buchtawill/wpi-grad-led/2025/invoice.pdf

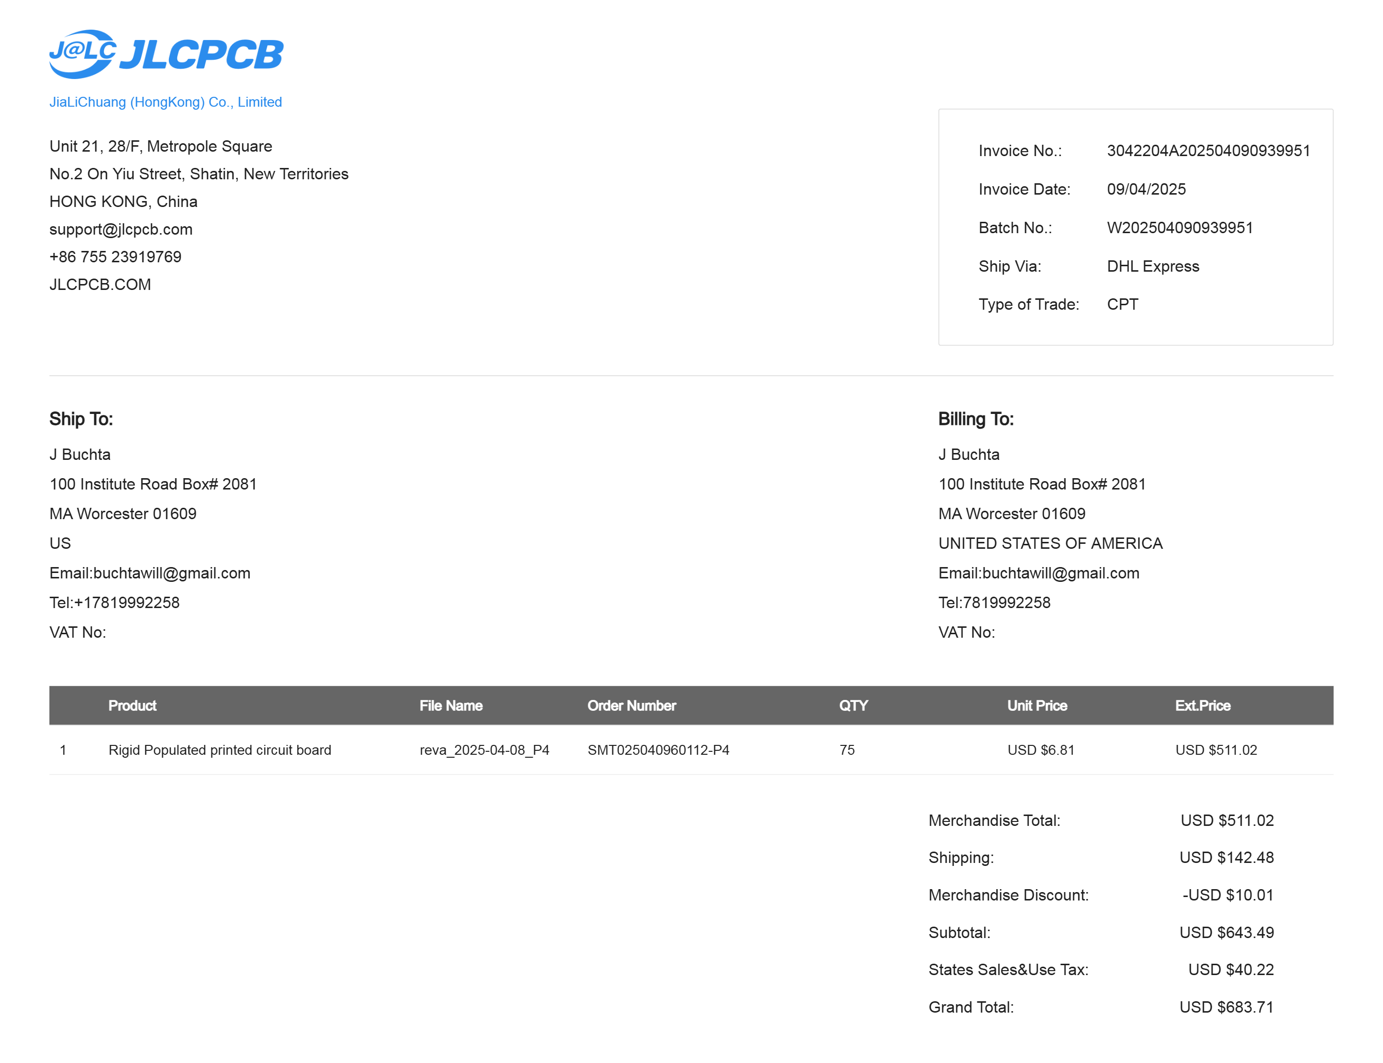
[picture p2: figure]
