buchtawill/wpi-grad-led/2025/cc_statement.png

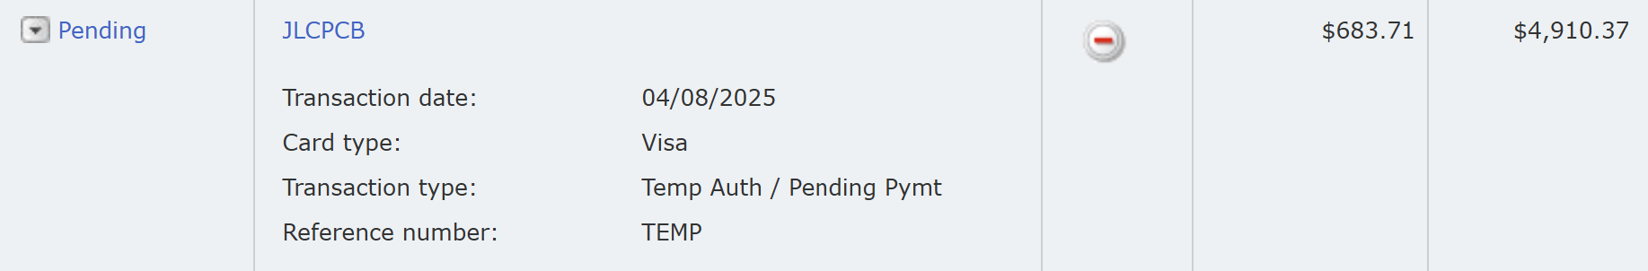
2025/cc_statement.png
