buchtawill/wpi-grad-led/2025/ece2025LEDs_animation.gif

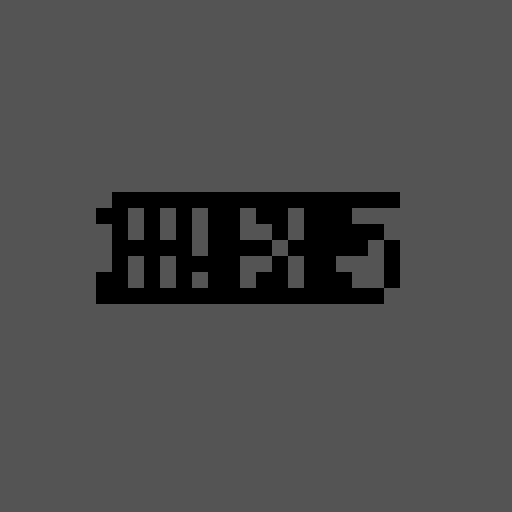
2025/ece2025LEDs_animation.gif
