buchtawill/wpi-grad-led/2025/ece2025LEDs_merged.png

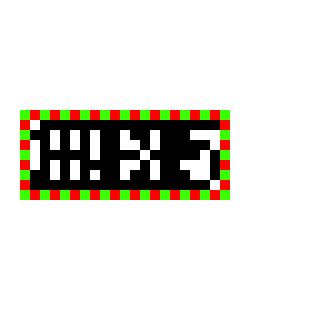
2025/ece2025LEDs_merged.png
