buchtawill/wpi-grad-led/2025/costs.xlsx

No charging CR2450
Item | Part # | Unit cost | Qty | Extended
CR2450 | 490-18648-ND | 0.5954 | 100 | 59.54
Boost | C2071163 | 0.1235 | 100 | 12.35
BJT | C2150 | 0.0119 | 900 | 10.71
LED | C22461786 | 0.0095 | 10000 | 95 | 101.65 if ordering 9500
DFF - xx174 | C6828 | 0.2166 | 100 | 21.66
NE555 | C7593 | 0.0806 | 100 | 8.06
USBC | C165948 | 0.1335 | 100 | 13.35
Resistors |  |  |  | 0
 |  |  |  | 0
 |  |  |  | 220.67
 |  |  | Assuming 50-60 boards
Second Revision | Unit Cost | Qty per board | Extended | Link / pn
Bulk AAs | 0.15 | 2 | 0.3 | https://a.co/d/etzIdbg
AA Holder | 0.38 | 1 | 0.38 | https://a.co/d/iyl8QFg
Shift Register | 0.0918 | 1 | 0.0918 | C5947
PCA9635 | 1.2645 | 3 | 3.7935 | C2678753
STM32F030 | 0.5415 | 1 | 0.5415 | C62514
 |  |  | 0
 |  |  | 0
 |  |  | 0
 |  |  | 0
 |  |  | 0
 |  | Total / board | 5.1068
