buchtawill/wpi-grad-led/2025/eagle/bom/bom_jlc.xlsx

Qty | Value | Device | Package | Parts | JLCPCB Part Number
9 |  | NPN-TRANSISTOR_SOT23 | SOT23 | Q1, Q2, Q3, Q4, Q5, Q6, QB, QG, QR | C2150
92 | 470 | R-US_R0603 | R0603 | R3, R4, R5, R6, R7, R8, R9, R10, R11, R12, R13, R14, R15, R16, R17, R18, R19, R20, R21, R22, R23, R24, R25, R26, R27, R28, R29, R30, R31, R32, R33, R34, R35, R36, R37, R38, R39, R40, R41, R42, R43, R44, R45, R46, R47, R48, R49, R50, R51, R52, R53, R54, R55, R56, R57, R58, R59, R60, R61, R62, R63, R64, R65, R66, R67, R68, R69, R70, R71, R72, R73, R74, R75, R77, R78, R79, R80, R81, R82, R83, R84, R85, R86, R87, R88, R89, R90, R91, R92, R93, R94, R95, R1, R2, R98, R99, R100 | C23179
1 | 100 | R-US_R0603 | R0603 | R108 | C23162
4 | 100n | C-USC0603 | C0603 | C1, C3, C5, C6 | C1591
5 | 10u | C-USC0805 | C0805 | C2, C4, C7, C8 | C1713
7 | 4k7 | R-US_R0603 | R0603 | R101, R102, R103, R104, R105, R106, R107 | C23162
1 | 74HC174D | 74HC174D | SO16 | IC2 | C6828
1 | 680k | R-US_R0603 | R0603 | R76 | C25822
4 | 75k | R-US_R0603 | R0603 | R96, R97, R109, R110 | C23242
1 | CR2450 | CR2450 | CR240_CASE | BAT1 | C964806
1 | LM555D | LM555D | SO08 | IC1 | C7593
1 | LQH3NPN2R2MJRL | LQH3NPN2R2MJRL | IND_LQH3NPN2R2MJRL | L1 | C9890
94 | RGB_LED_XL | RGB_LED_XL | LED2727 | DA2, DA3, DA4, DA5, DA6, DA7, DA8, DA9, DA10, DA11, DA12, DA13, DA14, DA15, DA16, DA17, DA18, DA19, DB1, DB2, DB4, DB6, DB8, DB9, DB11, DB12, DB14, DB15, DB16, DC2, DC4, DC6, DC8, DC9, DC12, DC14, DC15, DC16, DC17, DC18, DD2, DD3, DD4, DD5, DD6, DD8, DD9, DD10, DD11, DD13, DD14, DD15, DD16, DD17, DD19, DE2, DE4, DE6, DE7, DE8, DE9, DE12, DE14, DE15, DE19, DF1, DF2, DF4, DF6, DF8, DF9, DF11, DF12, DF14, DF15, DF19, DG1, DG2, DG3, DG4, DG5, DG6, DG7, DG8, DG9, DG10, DG11, DG12, DG13, DG14, DG15, DG16, DG17, DG18 | C22461786
1 | SWITCH-BRUH | SWITCH-BRUH | SW-K31391B | PWR | C92656
1 | TPS63000DRCR | TPS63000DRCR | VREG_V62/16624-01YE | U1 | C2876573
1 | TYPE-C-31-M-12 | TYPE-C-31-M-12 | HRO_TYPE-C-31-M-12 | J1 | C165948
