buchtawill/wpi-grad-led/2025/eagle/reva_sch.pdf

A
B

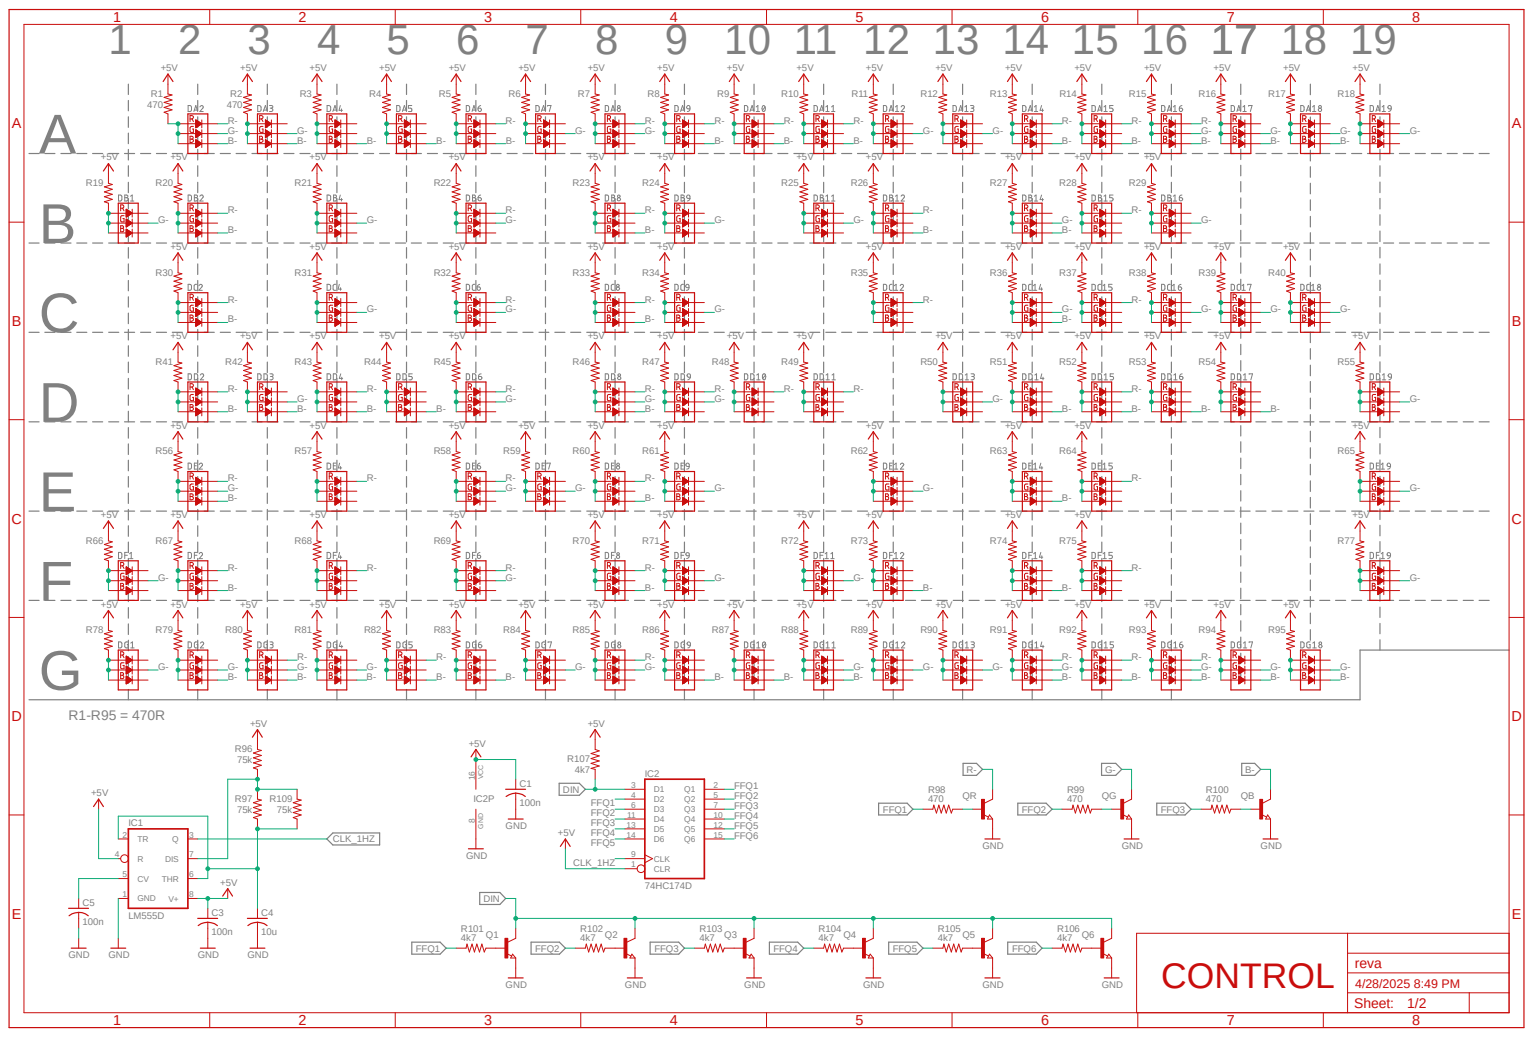
[picture p6: page 1]

CONTROL

Sheet: 1/2

A

A

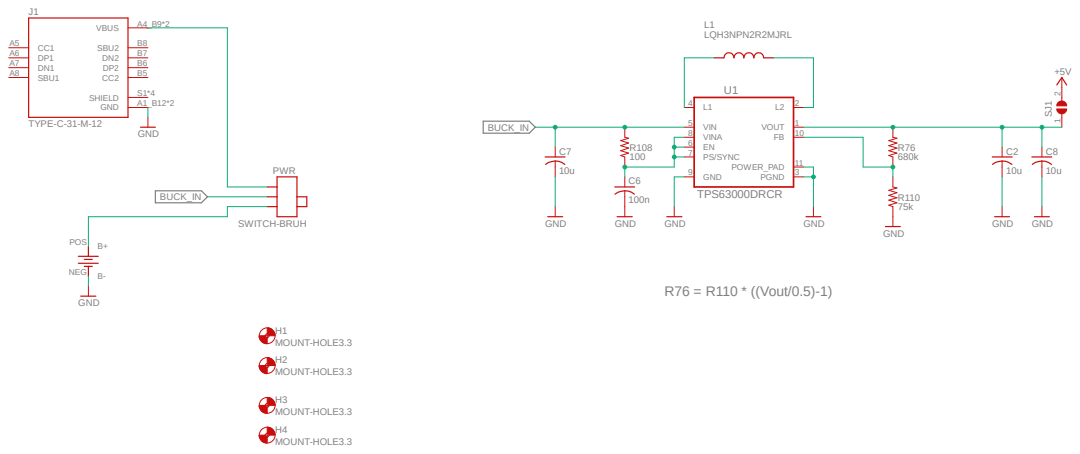
[picture p7: page 2]

+5V MOUNT-HOLE3.3 MOUNT-HOLE3.3 MOUNT-HOLE3.3 MOUNT-HOLE3.3

R76 = R110 * ((Vout/0.5)-1) SWITCH-BRUH GND
H1 H2 H3 H4 B+ POS

PWR

Sheet: 2/2
