buchtawill/wpi-grad-led/2025/eagle/reva.brd

## EAGLE design 2025/eagle/reva.brd (2026-03-22)

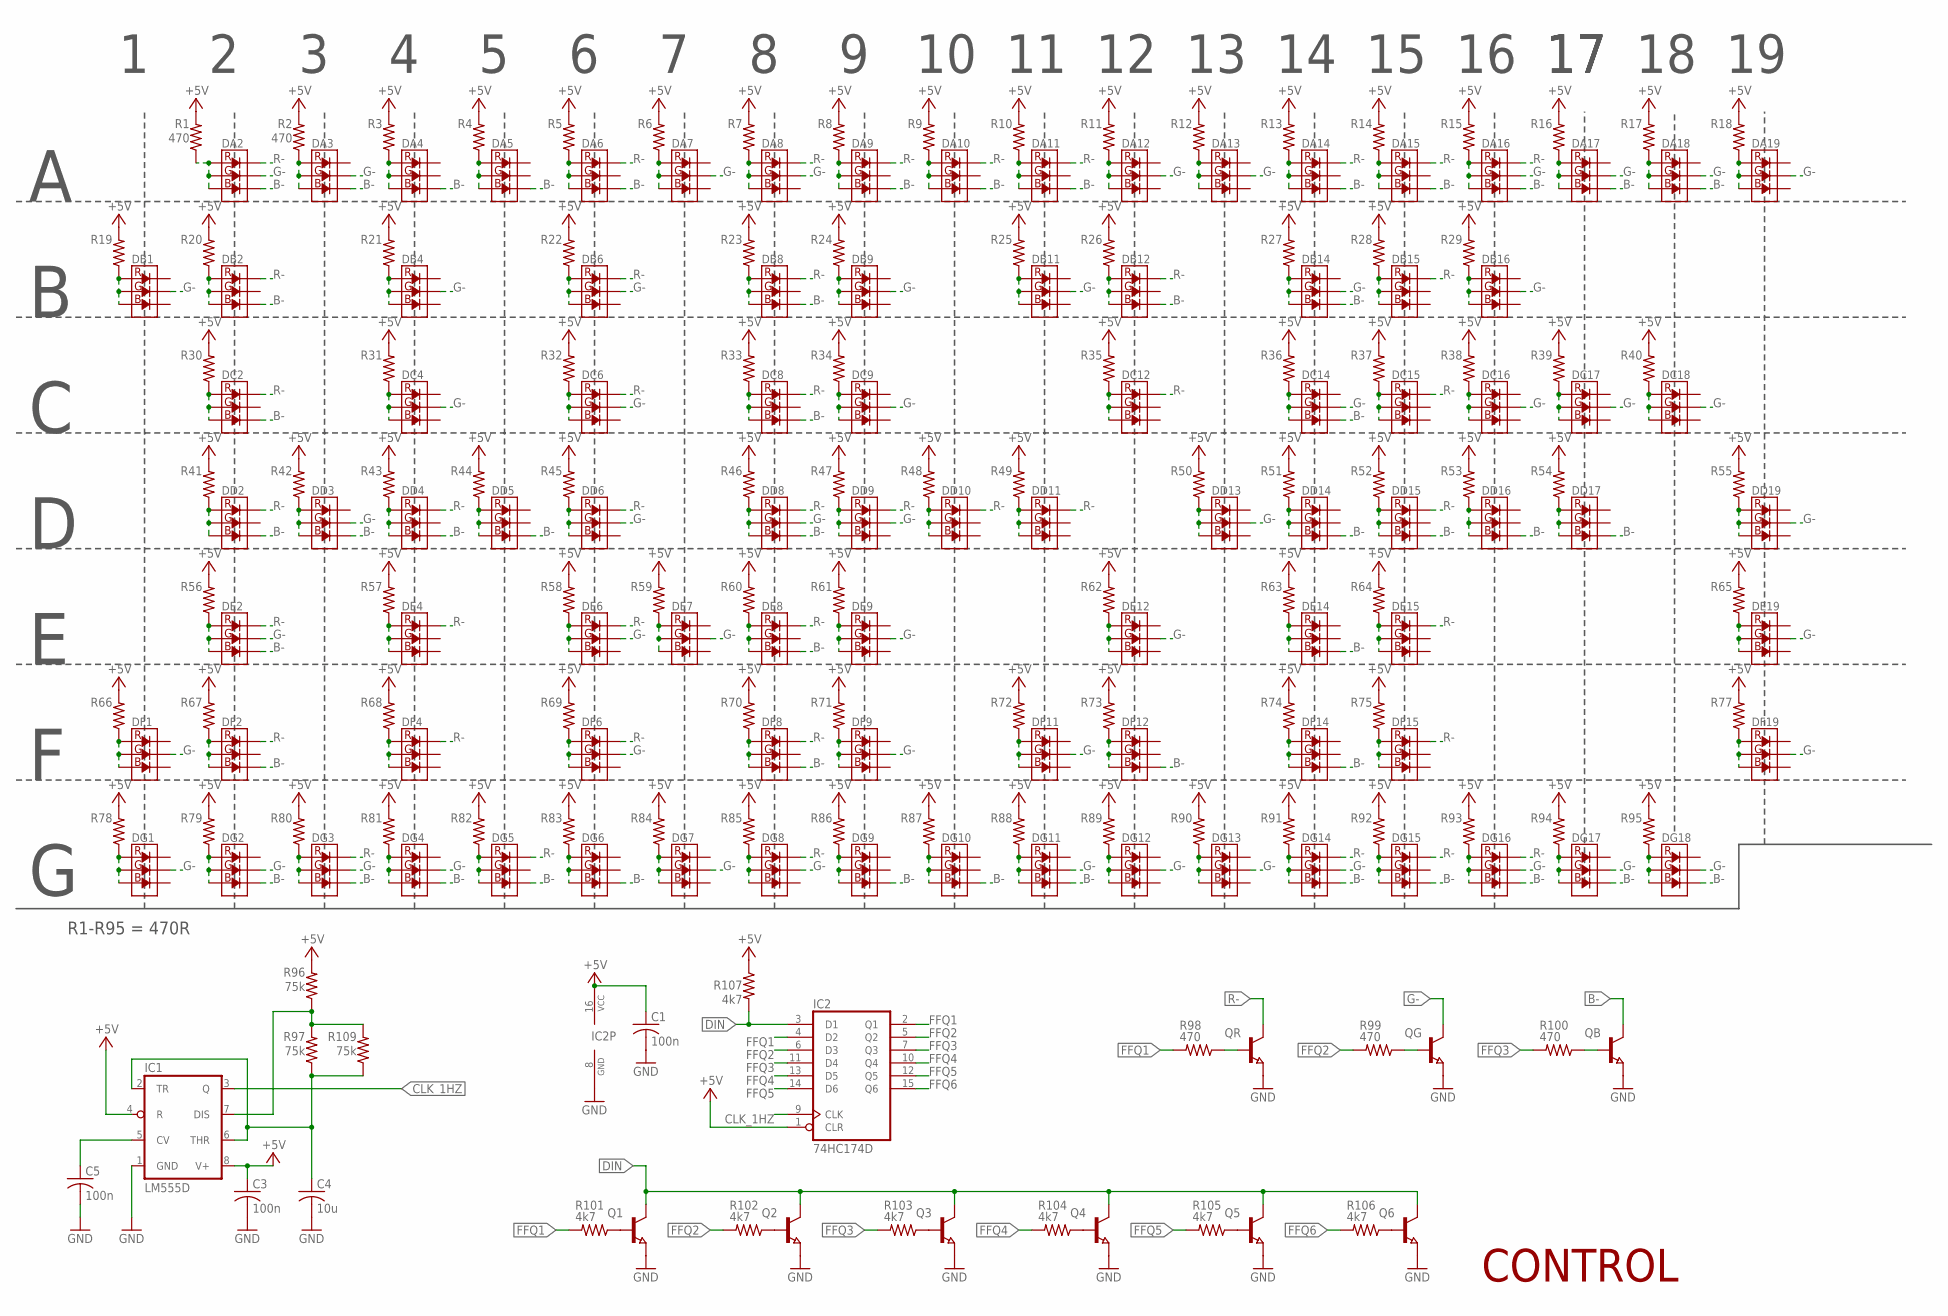
[picture p8: schematic reva.sch, sheet 1]

Parts:
C1, C3, C5: 100n; C0603
C4: 10u; C0805
DA2, DA3, DA4, DA5, DA6, DA7, DA8, DA9, DA10, DA11, DA12, DA13, DA14, DA15, DA16, DA17, DA18, DA19: RGB_LED_XL; LED2727
DB1, DB2, DB4, DB6, DB8, DB9, DB11, DB12, DB14, DB15, DB16: RGB_LED_XL; LED2727
DC2, DC4, DC6, DC8, DC9, DC12, DC14, DC15, DC16, DC17, DC18: RGB_LED_XL; LED2727
DD2, DD3, DD4, DD5, DD6, DD8, DD9, DD10, DD11, DD13, DD14, DD15, DD16, DD17, DD19: RGB_LED_XL; LED2727
DE2, DE4, DE6, DE7, DE8, DE9, DE12, DE14, DE15, DE19: RGB_LED_XL; LED2727
DF1, DF2, DF4, DF6, DF8, DF9, DF11, DF12, DF14, DF15, DF19: RGB_LED_XL; LED2727
DG1, DG2, DG3, DG4, DG5, DG6, DG7, DG8, DG9, DG10, DG11, DG12, DG13, DG14, DG15, DG16, DG17, DG18: RGB_LED_XL; LED2727
IC1: LM555D; SO08
IC2: 74HC174D; SO16
Q1, Q2, Q3, Q4, Q5, Q6: NPN-TRANSISTOR_SOT23; SOT23
QB: NPN-TRANSISTOR_SOT23; SOT23
QG: NPN-TRANSISTOR_SOT23; SOT23
QR: NPN-TRANSISTOR_SOT23; SOT23
R1, R2, R98, R99, R100: 470; R0603
R3, R4, R5, R6, R7, R8, R9, R10, R11, R12, R13, R14, R15, R16, R17, R18, R19, R20, R21, R22, R23, R24, R25, R26, R27, R28, R29, R30, R31, R32, R33, R34, R35, R36, R37, R38, R39, R40, R41, R42, R43, R44, R45, R46, R47, R48, R49, R50, R51, R52, R53, R54, R55, R56, R57, R58, R59, R60, R61, R62, R63, R64, R65, R66, R67, R68, R69, R70, R71, R72, R73, R74, R75, R77, R78, R79, R80, R81, R82, R83, R84, R85, R86, R87, R88, R89, R90, R91, R92, R93, R94, R95: R-US_R0603; R0603
R96, R97, R109: 75k; R0603
R101, R102, R103, R104, R105, R106, R107: 4k7; R0603

Connections:
+5V: C1.1, C3.1, IC1.4 (R), IC1.8 (V+), IC2.1 (CLR), IC2.16 (VCC), R1.2, R2.2, R3.2, R4.2, R5.2, R6.2, R7.2, R8.2, R9.2, R10.2, R11.2, R12.2, R13.2, R14.2, R15.2, R16.2, R17.2, R18.2, R19.2, R20.2, R21.2, R22.2, R23.2, R24.2, R25.2, R26.2, R27.2, R28.2, R29.2, R30.2, R31.2, R32.2, R33.2, R34.2, R35.2, R36.2, R37.2, R38.2, R39.2, R40.2, R41.2, R42.2, R43.2, R44.2, R45.2, R46.2, R47.2, R48.2, R49.2, R50.2, R51.2, R52.2, R53.2, R54.2, R55.2, R56.2, R57.2, R58.2, R59.2, R60.2, R61.2, R62.2, R63.2, R64.2, R65.2, R66.2, R67.2, R68.2, R69.2, R70.2, R71.2, R72.2, R73.2, R74.2, R75.2, R77.2, R78.2, R79.2, R80.2, R81.2, R82.2, R83.2, R84.2, R85.2, R86.2, R87.2, R88.2, R89.2, R90.2, R91.2, R92.2, R93.2, R94.2, R95.2, R96.2, R107.1; also elsewhere on the board
B-: DA2.1 (B-), DA3.1 (B-), DA4.1 (B-), DA5.1 (B-), DA6.1 (B-), DA9.1 (B-), DA10.1 (B-), DA11.1 (B-), DA14.1 (B-), DA15.1 (B-), DA16.1 (B-), DA17.1 (B-), DA18.1 (B-), DB2.1 (B-), DB8.1 (B-), DB12.1 (B-), DB14.1 (B-), DC2.1 (B-), DC8.1 (B-), DC14.1 (B-), DD2.1 (B-), DD3.1 (B-), DD4.1 (B-), DD5.1 (B-), DD8.1 (B-), DD14.1 (B-), DD15.1 (B-), DD16.1 (B-), DD17.1 (B-), DE2.1 (B-), DE8.1 (B-), DE14.1 (B-), DF2.1 (B-), DF8.1 (B-), DF12.1 (B-), DF14.1 (B-), DG2.1 (B-), DG3.1 (B-), DG4.1 (B-), DG5.1 (B-), DG6.1 (B-), DG9.1 (B-), DG10.1 (B-), DG11.1 (B-), DG14.1 (B-), DG15.1 (B-), DG16.1 (B-), DG17.1 (B-), DG18.1 (B-), QB.3 (C)
CLK_1HZ: IC1.3 (Q), IC2.9 (CLK)
CV: C5.1, IC1.5 (CV)
DIN: IC2.3 (D1), Q1.3 (C), Q2.3 (C), Q3.3 (C), Q4.3 (C), Q5.3 (C), Q6.3 (C), R107.2
DIS: IC1.7 (DIS), R96.1, R97.2, R109.2
FFQ1: IC2.2 (Q1), IC2.4 (D2), R98.2, R101.2
FFQ2: IC2.5 (Q2), IC2.6 (D3), R99.2, R102.2
FFQ3: IC2.7 (Q3), IC2.11 (D4), R100.2, R103.2
FFQ4: IC2.10 (Q4), IC2.13 (D5), R104.2
FFQ5: IC2.12 (Q5), IC2.14 (D6), R105.2
FFQ6: IC2.15 (Q6), R106.2
G-: DA2.2 (G-), DA3.2 (G-), DA7.2 (G-), DA8.2 (G-), DA12.2 (G-), DA13.2 (G-), DA16.2 (G-), DA17.2 (G-), DA18.2 (G-), DA19.2 (G-), DB1.2 (G-), DB4.2 (G-), DB6.2 (G-), DB9.2 (G-), DB11.2 (G-), DB14.2 (G-), DB16.2 (G-), DC4.2 (G-), DC6.2 (G-), DC9.2 (G-), DC14.2 (G-), DC16.2 (G-), DC17.2 (G-), DC18.2 (G-), DD3.2 (G-), DD6.2 (G-), DD8.2 (G-), DD9.2 (G-), DD13.2 (G-), DD19.2 (G-), DE2.2 (G-), DE6.2 (G-), DE7.2 (G-), DE9.2 (G-), DE12.2 (G-), DE19.2 (G-), DF1.2 (G-), DF6.2 (G-), DF9.2 (G-), DF11.2 (G-), DF19.2 (G-), DG1.2 (G-), DG2.2 (G-), DG3.2 (G-), DG4.2 (G-), DG7.2 (G-), DG8.2 (G-), DG11.2 (G-), DG12.2 (G-), DG13.2 (G-), DG14.2 (G-), DG16.2 (G-), DG17.2 (G-), DG18.2 (G-), QG.3 (C)
GND: C1.2, C3.2, C4.2, C5.2, IC1.1 (GND), IC2.8 (GND), Q1.2 (E), Q2.2 (E), Q3.2 (E), Q4.2 (E), Q5.2 (E), Q6.2 (E), QB.2 (E), QG.2 (E), QR.2 (E); also elsewhere on the board
unnamed: DA2.4 (R+), DA2.5 (G+), DA2.6 (B+), R1.1
unnamed: DA3.4 (R+), DA3.5 (G+), DA3.6 (B+), R2.1
unnamed: DA4.4 (R+), DA4.5 (G+), DA4.6 (B+), R3.1
unnamed: DA5.4 (R+), DA5.5 (G+), DA5.6 (B+), R4.1
unnamed: DA6.4 (R+), DA6.5 (G+), DA6.6 (B+), R5.1
unnamed: DA7.4 (R+), DA7.5 (G+), DA7.6 (B+), R6.1
unnamed: DA8.4 (R+), DA8.5 (G+), DA8.6 (B+), R7.1
unnamed: DA9.4 (R+), DA9.5 (G+), DA9.6 (B+), R8.1
unnamed: DA10.4 (R+), DA10.5 (G+), DA10.6 (B+), R9.1
unnamed: DA11.4 (R+), DA11.5 (G+), DA11.6 (B+), R10.1
unnamed: DA12.4 (R+), DA12.5 (G+), DA12.6 (B+), R11.1
unnamed: DA13.4 (R+), DA13.5 (G+), DA13.6 (B+), R12.1
unnamed: DA14.4 (R+), DA14.5 (G+), DA14.6 (B+), R13.1
unnamed: DA15.4 (R+), DA15.5 (G+), DA15.6 (B+), R14.1
unnamed: DA16.4 (R+), DA16.5 (G+), DA16.6 (B+), R15.1
unnamed: DA17.4 (R+), DA17.5 (G+), DA17.6 (B+), R16.1
unnamed: DA18.4 (R+), DA18.5 (G+), DA18.6 (B+), R17.1
unnamed: DA19.4 (R+), DA19.5 (G+), DA19.6 (B+), R18.1
unnamed: DB1.4 (R+), DB1.5 (G+), DB1.6 (B+), R19.1
unnamed: DB2.4 (R+), DB2.5 (G+), DB2.6 (B+), R20.1
unnamed: DB4.4 (R+), DB4.5 (G+), DB4.6 (B+), R21.1
unnamed: DB6.4 (R+), DB6.5 (G+), DB6.6 (B+), R22.1
unnamed: DB8.4 (R+), DB8.5 (G+), DB8.6 (B+), R23.1
unnamed: DB9.4 (R+), DB9.5 (G+), DB9.6 (B+), R24.1
unnamed: DB11.4 (R+), DB11.5 (G+), DB11.6 (B+), R25.1
unnamed: DB12.4 (R+), DB12.5 (G+), DB12.6 (B+), R26.1
unnamed: DB14.4 (R+), DB14.5 (G+), DB14.6 (B+), R27.1
unnamed: DB15.4 (R+), DB15.5 (G+), DB15.6 (B+), R28.1
unnamed: DB16.4 (R+), DB16.5 (G+), DB16.6 (B+), R29.1
unnamed: DC2.4 (R+), DC2.5 (G+), DC2.6 (B+), R30.1
unnamed: DC4.4 (R+), DC4.5 (G+), DC4.6 (B+), R31.1
unnamed: DC6.4 (R+), DC6.5 (G+), DC6.6 (B+), R32.1
unnamed: DC8.4 (R+), DC8.5 (G+), DC8.6 (B+), R33.1
unnamed: DC9.4 (R+), DC9.5 (G+), DC9.6 (B+), R34.1
unnamed: DC12.4 (R+), DC12.5 (G+), DC12.6 (B+), R35.1
unnamed: DC14.4 (R+), DC14.5 (G+), DC14.6 (B+), R36.1
unnamed: DC15.4 (R+), DC15.5 (G+), DC15.6 (B+), R37.1
unnamed: DC16.4 (R+), DC16.5 (G+), DC16.6 (B+), R38.1
unnamed: DC17.4 (R+), DC17.5 (G+), DC17.6 (B+), R39.1
unnamed: DC18.4 (R+), DC18.5 (G+), DC18.6 (B+), R40.1
unnamed: DD2.4 (R+), DD2.5 (G+), DD2.6 (B+), R41.1
unnamed: DD3.4 (R+), DD3.5 (G+), DD3.6 (B+), R42.1
unnamed: DD4.4 (R+), DD4.5 (G+), DD4.6 (B+), R43.1
unnamed: DD5.4 (R+), DD5.5 (G+), DD5.6 (B+), R44.1
unnamed: DD6.4 (R+), DD6.5 (G+), DD6.6 (B+), R45.1
unnamed: DD8.4 (R+), DD8.5 (G+), DD8.6 (B+), R46.1
unnamed: DD9.4 (R+), DD9.5 (G+), DD9.6 (B+), R47.1
unnamed: DD10.4 (R+), DD10.5 (G+), DD10.6 (B+), R48.1
unnamed: DD11.4 (R+), DD11.5 (G+), DD11.6 (B+), R49.1
unnamed: DD13.4 (R+), DD13.5 (G+), DD13.6 (B+), R50.1
unnamed: DD14.4 (R+), DD14.5 (G+), DD14.6 (B+), R51.1
unnamed: DD15.4 (R+), DD15.5 (G+), DD15.6 (B+), R52.1
unnamed: DD16.4 (R+), DD16.5 (G+), DD16.6 (B+), R53.1
unnamed: DD17.4 (R+), DD17.5 (G+), DD17.6 (B+), R54.1
unnamed: DD19.4 (R+), DD19.5 (G+), DD19.6 (B+), R55.1
unnamed: DE2.4 (R+), DE2.5 (G+), DE2.6 (B+), R56.1
unnamed: DE4.4 (R+), DE4.5 (G+), DE4.6 (B+), R57.1
unnamed: DE6.4 (R+), DE6.5 (G+), DE6.6 (B+), R58.1
unnamed: DE7.4 (R+), DE7.5 (G+), DE7.6 (B+), R59.1
unnamed: DE8.4 (R+), DE8.5 (G+), DE8.6 (B+), R60.1
unnamed: DE9.4 (R+), DE9.5 (G+), DE9.6 (B+), R61.1
unnamed: DE12.4 (R+), DE12.5 (G+), DE12.6 (B+), R62.1
unnamed: DE14.4 (R+), DE14.5 (G+), DE14.6 (B+), R63.1
unnamed: DE15.4 (R+), DE15.5 (G+), DE15.6 (B+), R64.1
unnamed: DE19.4 (R+), DE19.5 (G+), DE19.6 (B+), R65.1
unnamed: DF1.4 (R+), DF1.5 (G+), DF1.6 (B+), R66.1
unnamed: DF2.4 (R+), DF2.5 (G+), DF2.6 (B+), R67.1
unnamed: DF4.4 (R+), DF4.5 (G+), DF4.6 (B+), R68.1
unnamed: DF6.4 (R+), DF6.5 (G+), DF6.6 (B+), R69.1
unnamed: DF8.4 (R+), DF8.5 (G+), DF8.6 (B+), R70.1
unnamed: DF9.4 (R+), DF9.5 (G+), DF9.6 (B+), R71.1
unnamed: DF11.4 (R+), DF11.5 (G+), DF11.6 (B+), R72.1
unnamed: DF12.4 (R+), DF12.5 (G+), DF12.6 (B+), R73.1
unnamed: DF14.4 (R+), DF14.5 (G+), DF14.6 (B+), R74.1
unnamed: DF15.4 (R+), DF15.5 (G+), DF15.6 (B+), R75.1
unnamed: DF19.4 (R+), DF19.5 (G+), DF19.6 (B+), R77.1
unnamed: DG1.4 (R+), DG1.5 (G+), DG1.6 (B+), R78.1
unnamed: DG2.4 (R+), DG2.5 (G+), DG2.6 (B+), R79.1
unnamed: DG3.4 (R+), DG3.5 (G+), DG3.6 (B+), R80.1
unnamed: DG4.4 (R+), DG4.5 (G+), DG4.6 (B+), R81.1
unnamed: DG5.4 (R+), DG5.5 (G+), DG5.6 (B+), R82.1
unnamed: DG6.4 (R+), DG6.5 (G+), DG6.6 (B+), R83.1
unnamed: DG7.4 (R+), DG7.5 (G+), DG7.6 (B+), R84.1
unnamed: DG8.4 (R+), DG8.5 (G+), DG8.6 (B+), R85.1
unnamed: DG9.4 (R+), DG9.5 (G+), DG9.6 (B+), R86.1
unnamed: DG10.4 (R+), DG10.5 (G+), DG10.6 (B+), R87.1
unnamed: DG11.4 (R+), DG11.5 (G+), DG11.6 (B+), R88.1
unnamed: DG12.4 (R+), DG12.5 (G+), DG12.6 (B+), R89.1
unnamed: DG13.4 (R+), DG13.5 (G+), DG13.6 (B+), R90.1
unnamed: DG14.4 (R+), DG14.5 (G+), DG14.6 (B+), R91.1
unnamed: DG15.4 (R+), DG15.5 (G+), DG15.6 (B+), R92.1
unnamed: DG16.4 (R+), DG16.5 (G+), DG16.6 (B+), R93.1
unnamed: DG17.4 (R+), DG17.5 (G+), DG17.6 (B+), R94.1
unnamed: DG18.4 (R+), DG18.5 (G+), DG18.6 (B+), R95.1
Q1B: Q1.1 (B), R101.1
Q2B: Q2.1 (B), R102.1
Q3B: Q3.1 (B), R103.1
Q4B: Q4.1 (B), R104.1
Q5B: Q5.1 (B), R105.1
Q6B: Q6.1 (B), R106.1
QBB: QB.1 (B), R100.1
QGB: QG.1 (B), R99.1
QRB: QR.1 (B), R98.1
R-: DA2.3 (R-), DA6.3 (R-), DA8.3 (R-), DA9.3 (R-), DA10.3 (R-), DA11.3 (R-), DA14.3 (R-), DA15.3 (R-), DA16.3 (R-), DB2.3 (R-), DB6.3 (R-), DB8.3 (R-), DB12.3 (R-), DB15.3 (R-), DC2.3 (R-), DC6.3 (R-), DC8.3 (R-), DC12.3 (R-), DC15.3 (R-), DD2.3 (R-), DD4.3 (R-), DD6.3 (R-), DD8.3 (R-), DD9.3 (R-), DD10.3 (R-), DD11.3 (R-), DD15.3 (R-), DE2.3 (R-), DE4.3 (R-), DE6.3 (R-), DE8.3 (R-), DE15.3 (R-), DF2.3 (R-), DF4.3 (R-), DF6.3 (R-), DF8.3 (R-), DF15.3 (R-), DG3.3 (R-), DG5.3 (R-), DG8.3 (R-), DG14.3 (R-), DG15.3 (R-), DG16.3 (R-), QR.3 (C)
TR: C4.1, IC1.2 (TR), IC1.6 (THR), R97.1, R109.1

Notes on the sheet:
R1-R95 = 470R
CONTROL

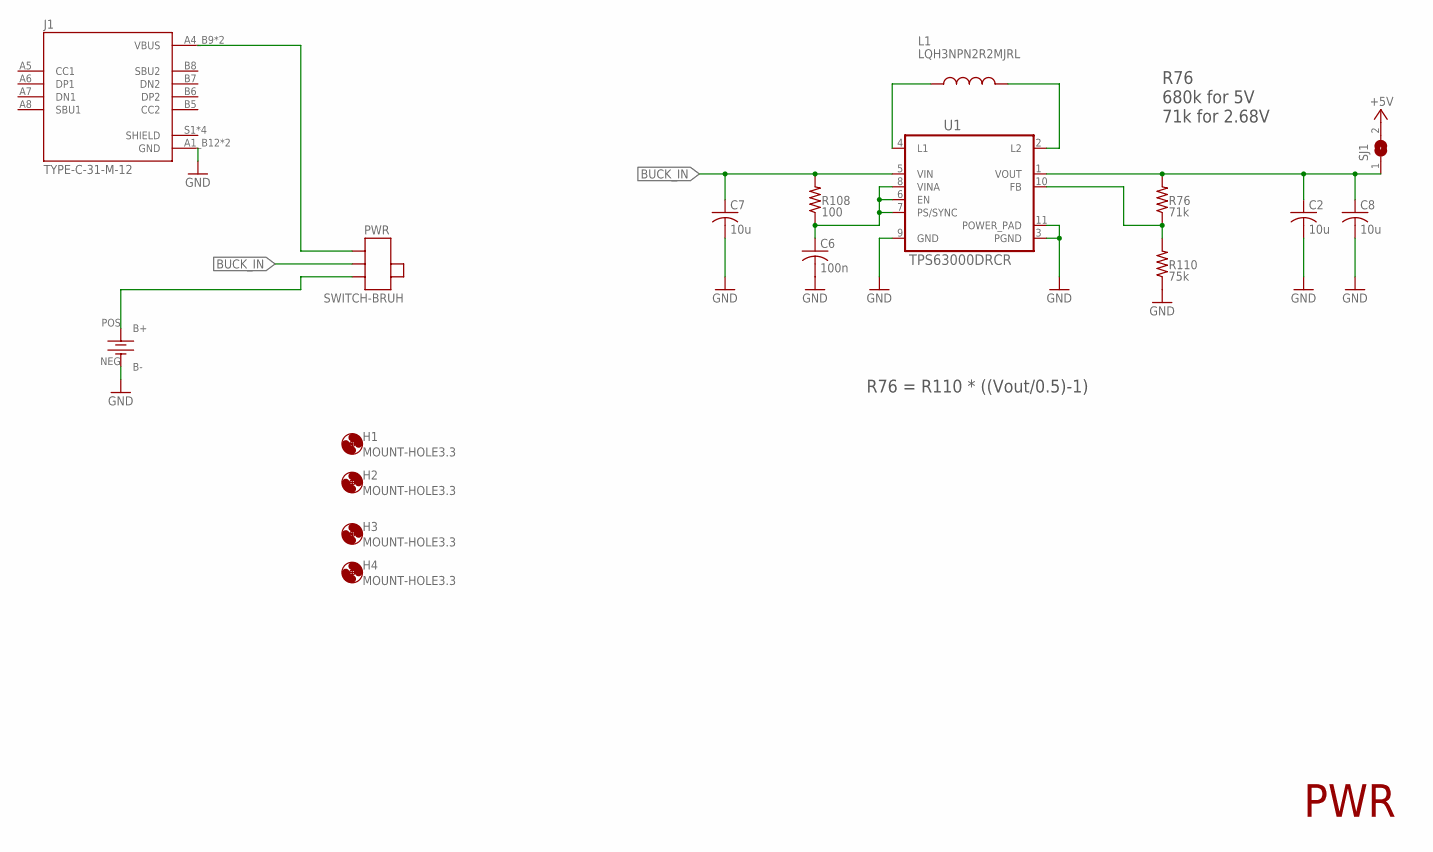
[picture p9: schematic reva.sch, sheet 2]

Parts:
BAT1: CR2450; CR240_CASE
C2, C7, C8: 10u; C0805
C6: 100n; C0603
H1, H2, H3, H4: MOUNT-HOLE3.3; 3,3
J1: TYPE-C-31-M-12; HRO_TYPE-C-31-M-12
L1: LQH3NPN2R2MJRL; IND_LQH3NPN2R2MJRL
PWR: SWITCH-BRUH; SW-K31391B
R76: 71k; R0603
R108: 100; R0603
R110: 75k; R0603
SJ1: SJ
U1: TPS63000DRCR; VREG_V62/16624-01YE

Connections:
5VBUCK: C2.1, C8.1, R76.2, SJ1.1, U1.1 (VOUT)
+5V: SJ1.2; also elsewhere on the board
BUCK_IN: C7.1, PWR.COM (C), R108.2, U1.5 (VIN)
GND: BAT1.NEG (B-), C2.2, C6.2, C7.2, C8.2, J1.A1_B12 (GND), J1.B1_A12 (GND), R110.1, U1.3 (PGND), U1.9 (GND), U1.11 (POWER_PAD); also elsewhere on the board
L1: L1.1, U1.4 (L1)
L2: L1.2, U1.2 (L2)
unnamed: R76.1, R110.2, U1.10 (FB)
unnamed: J1.A4_B9 (VBUS), J1.B4_A9 (VBUS), PWR.L (T1)
unnamed: BAT1.POS (B+), PWR.R (T2)
VINA: C6.1, R108.1, U1.6 (EN), U1.7 (PS/SYNC), U1.8 (VINA)

Notes on the sheet:
PWR
R76 = R110 * ((Vout/0.5)-1)
R76 680k for 5V 71k for 2.68V

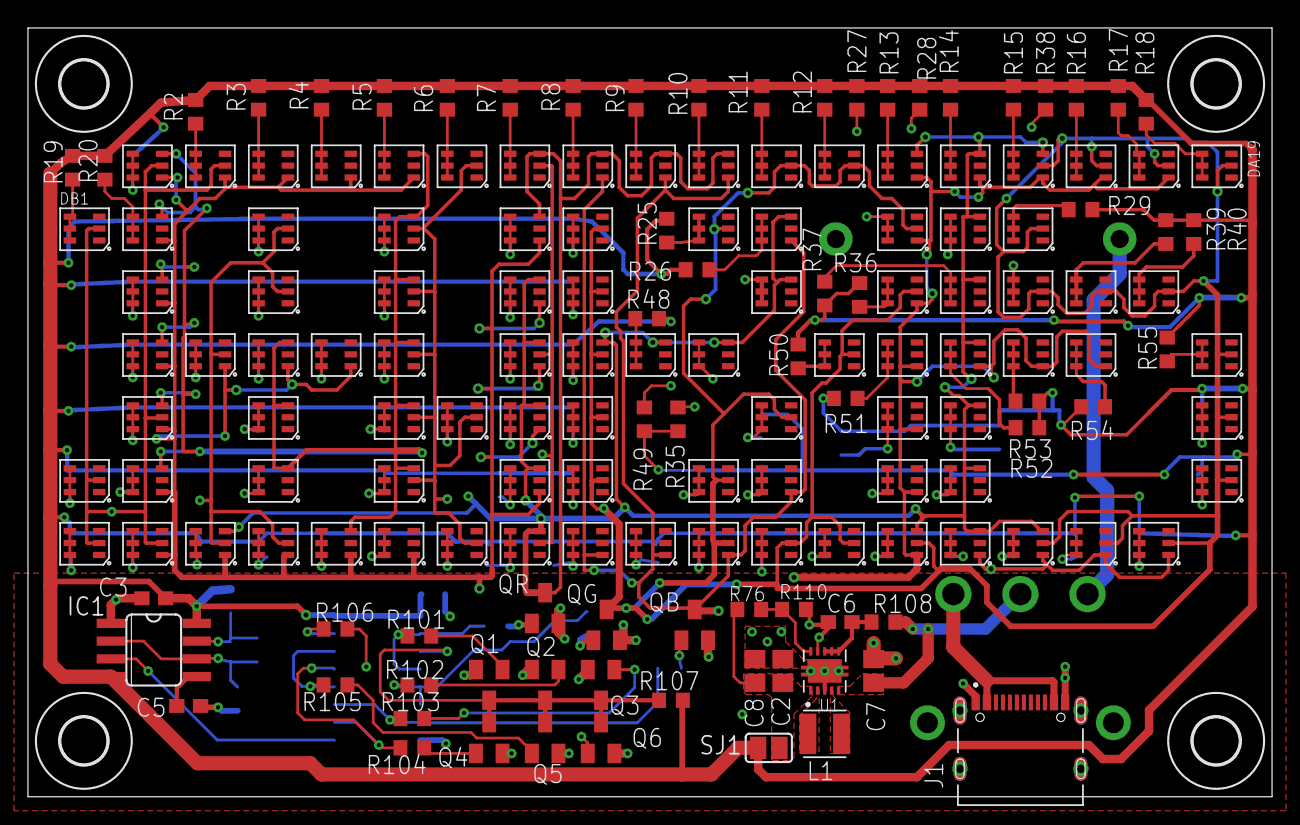
[picture p10: board reva.brd from above]

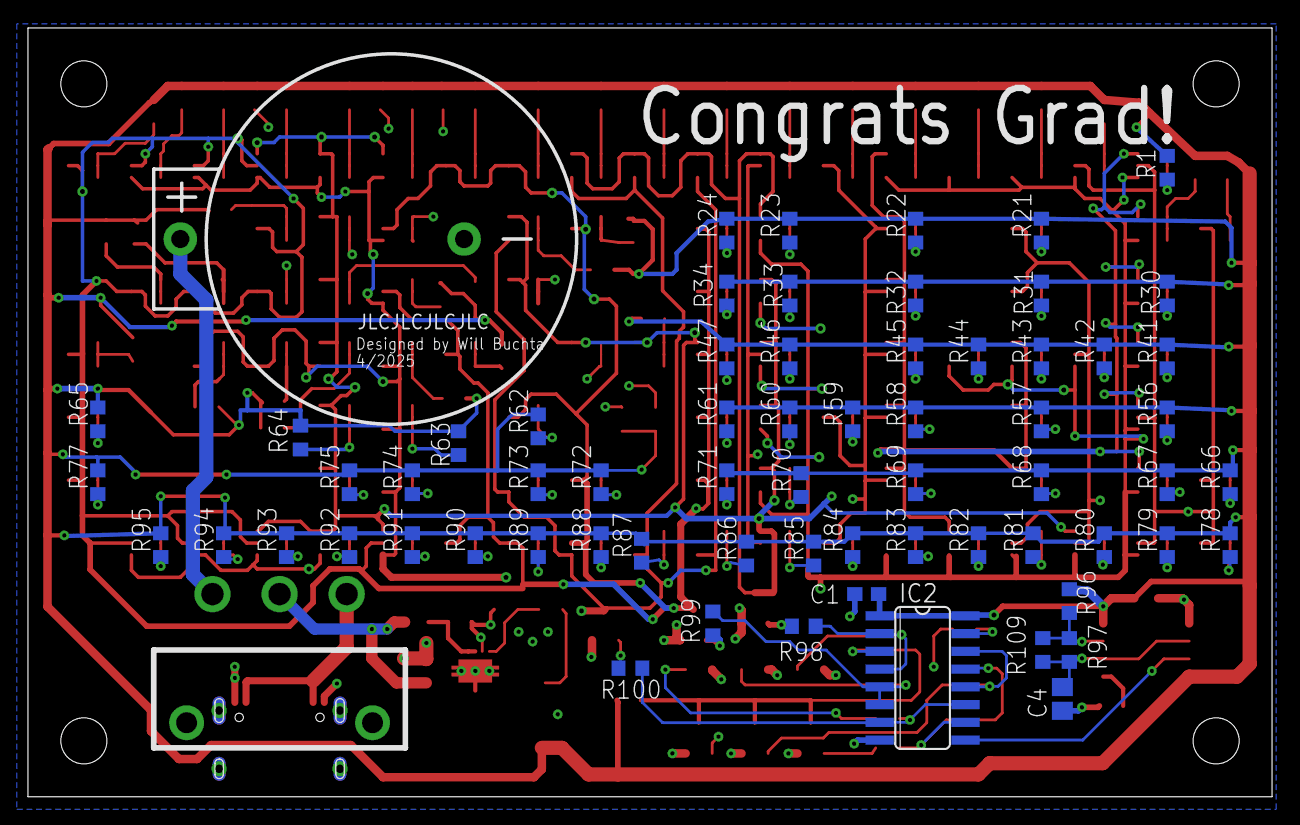
[picture p11: board reva.brd from below]

Board: 4 copper layers, 89.0 x 55.0 mm, 233 parts (67 on the bottom side), 127 nets.
