buchtawill/wpi-grad-led/(commit log)

2025-04-04 Initial commit:
    [costs.xlsx, reva.brd, reva.sch]
2025-04-04 Save board state
    [reva.brd, reva.sch]
2025-04-05 Finish rough layout
    [reva.brd, reva.sch]
2025-04-06 Make first prototype board
    [reva.brd]
2025-04-06 Change battery holder, create BOM and PNP
    [bom_jlc.xlsx, reva.brd, reva.csv, reva.sch, reva_pnp_jlc.xlsx]
2025-04-07 Fix 555 error
    [bom_jlc.xlsx, reva.brd, reva.sch, reva_pnp_jlc.xlsx]
2025-04-08 Change buck to have 20uF Cout, increase inductor footprint size
    [bom_jlc.xlsx, reva.brd, reva.sch, reva_pnp_jlc.xlsx]
2025-04-08 Add resistive feedback to TP63000
    [bom_jlc.xlsx, reva.brd, reva.sch]
2025-04-13 Pre 0603 change
    [bom_jlc.xlsx, reva.brd, reva_pnp_jlc.xlsx]
2025-04-14 Change pads to 0603 and move some resistors around. This commit marks final draft
    [bom_jlc.xlsx, reva.brd, reva.sch, reva_pnp_jlc.xlsx]
2026-03-22 Move to 2025 / 2026 folders
    [bom_jlc.xlsx, costs.xlsx, reva.brd, reva.csv, reva.sch, reva_pnp_jlc.xlsx]
